benvonhandorf/nOPe-1/subassembly/encoder/prototype/TestFirmware/firmware/src/led_array/2023-01-15-16-36-17.png

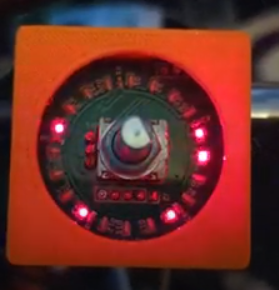
subassembly/encoder/prototype/TestFirmware/firmware/src/led_array/2023-01-15-16-36-17.png
