benvonhandorf/nOPe-1/subassembly/encoder/prototype/README.md

## Prototype Pinouts

- J1 - Communication header
  - 1 GND
  - 2 3.3V
  - 3 i2c SCL
  - 4 i2c SDA
  - 5 INT
- J2 - Programming Header
  - 1 GND
  - 2 3.3V
  - 3 ~RESET
  - 4 SWCLK
  - 5 SWDIO
