benvonhandorf/nOPe-1/subassembly/encoder/prototype/Rotary encoder board prototype schematic.pdf

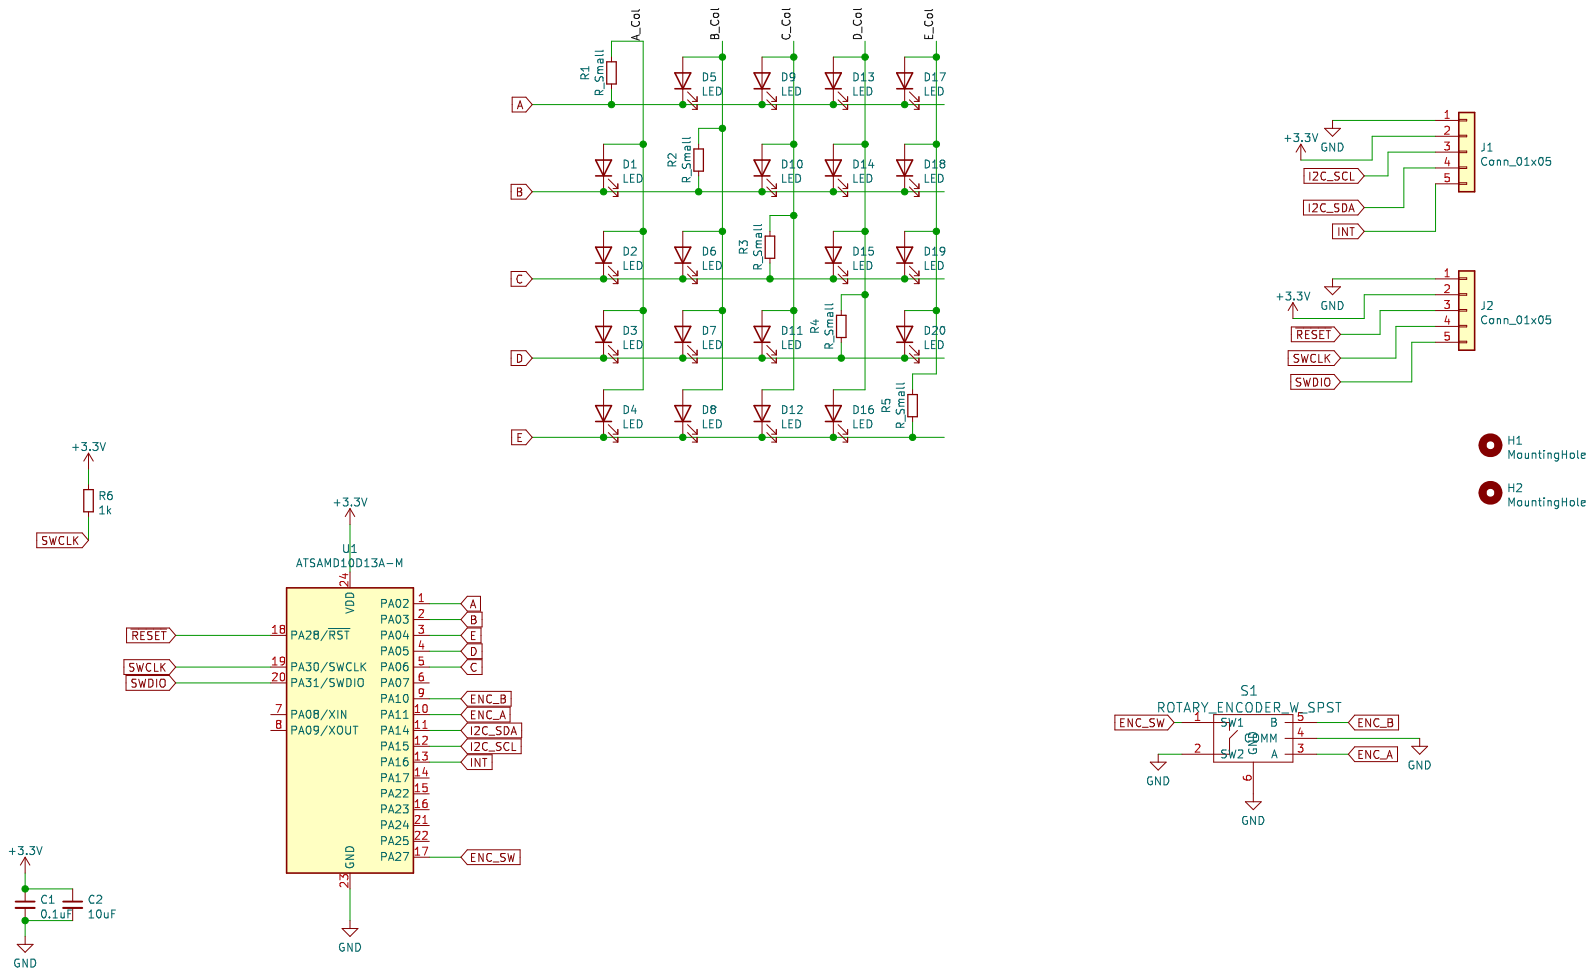
[picture p2: page 1]
