benvonhandorf/nOPe-1/subassembly/encoder/rotary_input_board/docs/schematic.pdf

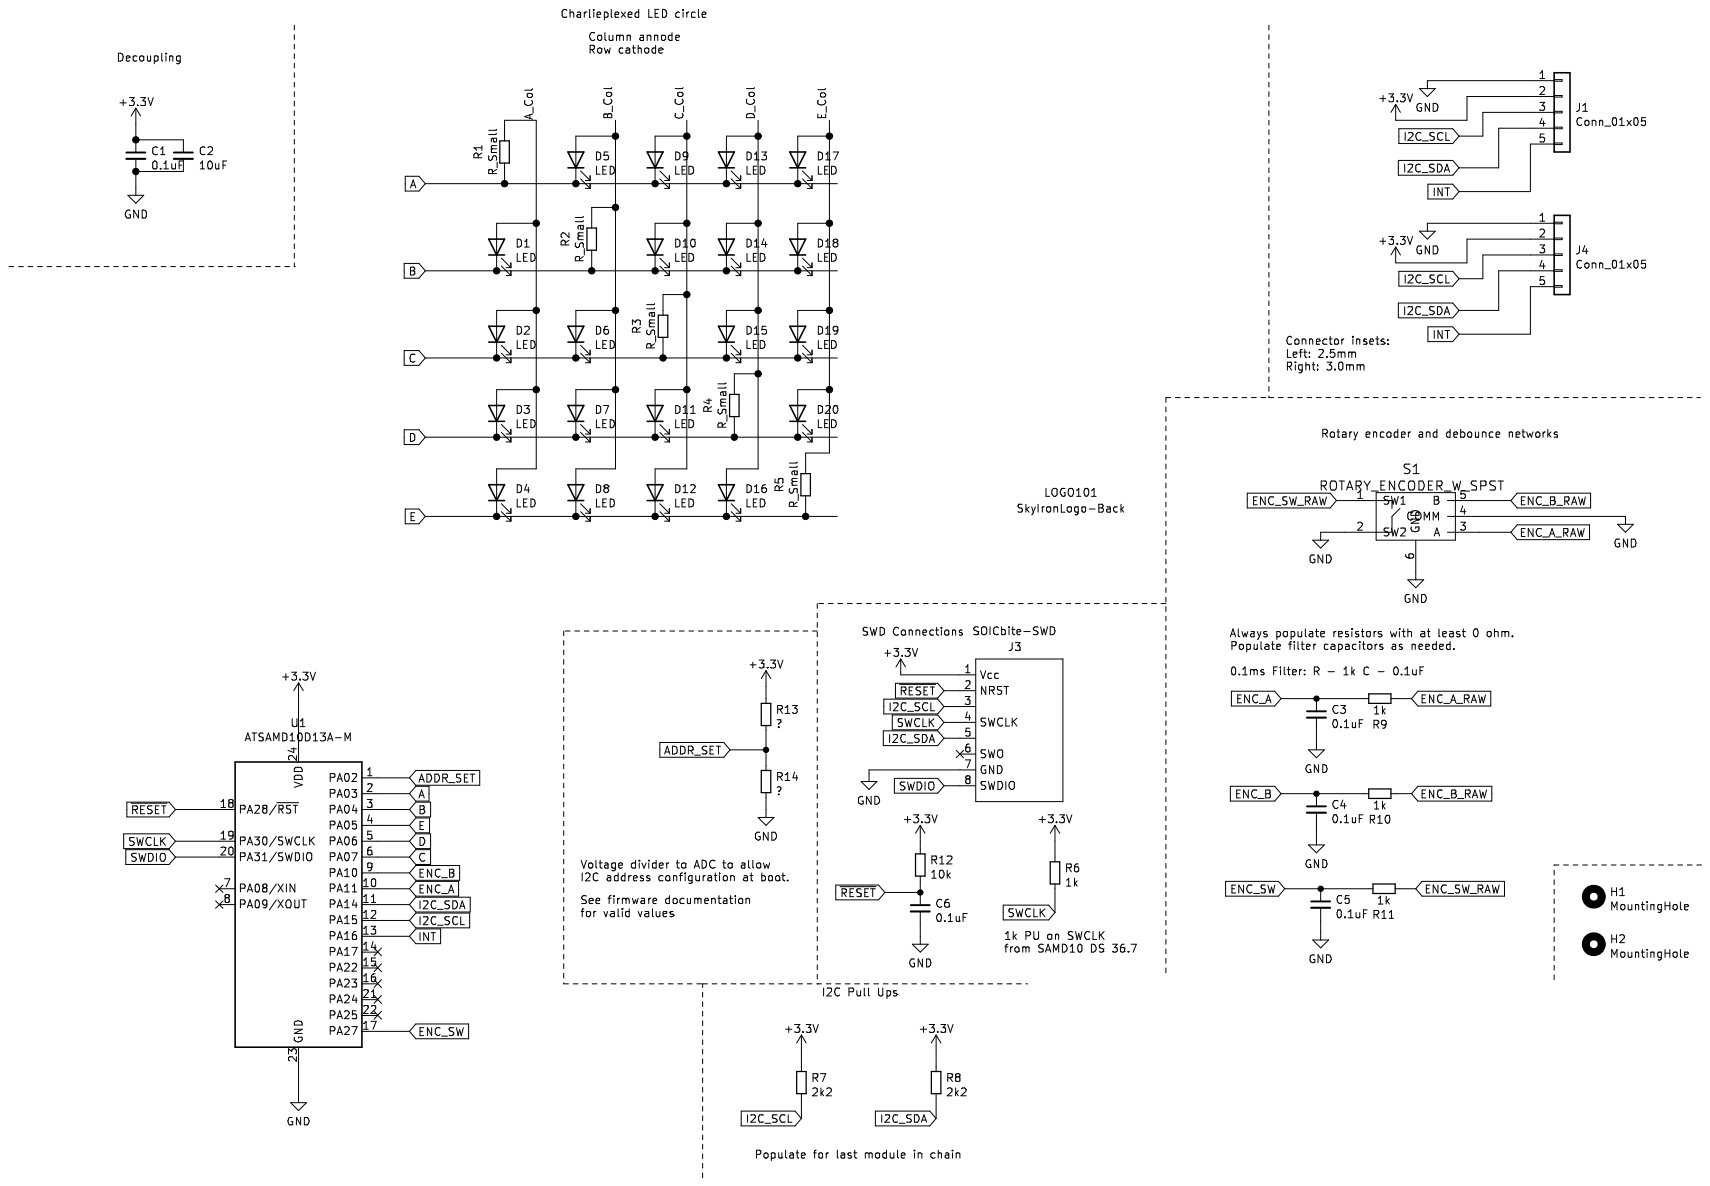
[picture p8: page 1]
