benvonhandorf/nOPe-1/subassembly/keyboard_matrix/keyboard_matrix/keyboard_matrix.kicad_pcb

## KiCad design subassembly/keyboard_matrix/keyboard_matrix/keyboard_matrix.kicad_pcb (2022-12-12)

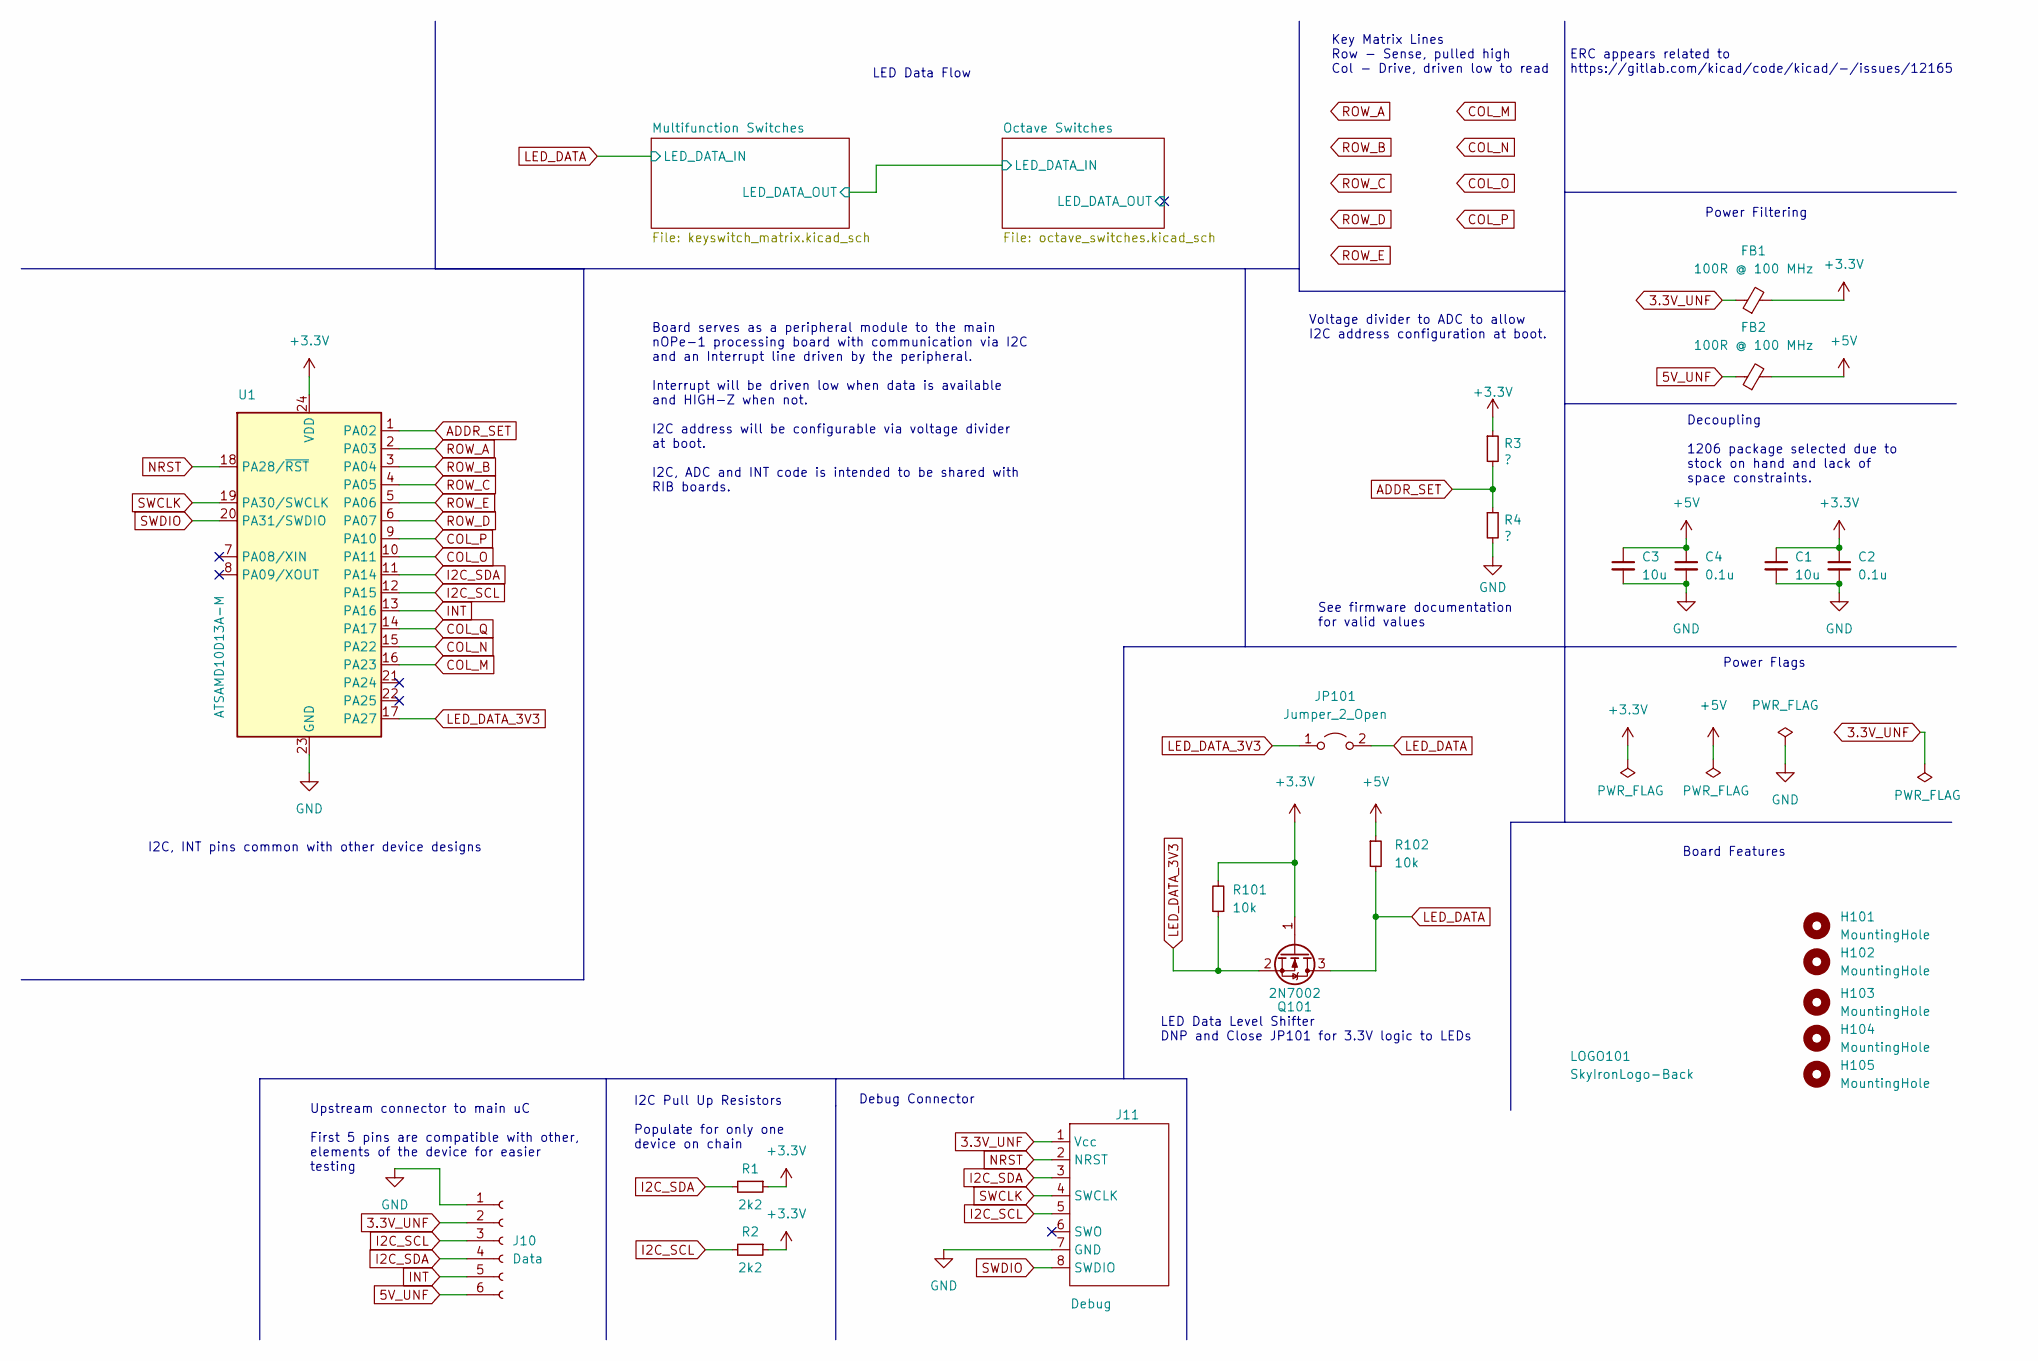
[picture p9: schematic keyboard_matrix.kicad_sch]

Parts:
C1, C3: 10u; C_1206_3216Metric_Pad1.33x1.80mm_HandSolder
C2, C4: 0.1u; C_1206_3216Metric_Pad1.33x1.80mm_HandSolder
FB1, FB2: 100R @ 100 MHz; R_0805_2012Metric_Pad1.20x1.40mm_HandSolder
H101, H102, H103, H104, H105: MountingHole; MountingHole_3.2mm_M3_DIN965
J10: Data; PinHeader_1x06_P2.54mm_Vertical
J11: Debug; SOICbite_renumbered
JP101: Jumper_2_Open; SolderJumper-2_P1.3mm_Open_Pad1.0x1.5mm
LOGO101: SkyIronLogo-Back; SkyIron_logo_Back
Q101: 2N7002; SOT-23
R1, R2: 2k2; R_0603_1608Metric
R3, R4: ?; R_0603_1608Metric
R101, R102: 10k; R_0805_2012Metric_Pad1.20x1.40mm_HandSolder
U1: ATSAMD10D13A-M; QFN-24-1EP_4x4mm_P0.5mm_EP2.6x2.6mm

Connections:
3.3V_UNF: FB1.1, J10.2, J11.1 (Vcc)
5V_UNF: FB2.1, J10.6
+3.3V: C1.1, C2.1, FB1.2, Q101.1 (G), R1.1, R2.1, R3.1, R101.2, U1.24 (VDD)
+5V: C3.1, C4.1, FB2.2, R102.1; also elsewhere on the board
ADDR_SET: R3.2, R4.1, U1.1 (PA02)
COL_M: U1.16 (PA23); also elsewhere on the board
COL_N: U1.15 (PA22); also elsewhere on the board
COL_O: U1.10 (PA11); also elsewhere on the board
COL_P: U1.9 (PA10); also elsewhere on the board
COL_Q: U1.14 (PA17); also elsewhere on the board
GND: C1.2, C2.2, C3.2, C4.2, J10.1, J11.7 (GND), R4.2, U1.23 (GND), U1.25 (GND); also elsewhere on the board
I2C_SCL: J10.3, J11.5, R2.2, U1.12 (PA15)
I2C_SDA: J10.4, J11.3, R1.2, U1.11 (PA14)
INT: J10.5, U1.13 (PA16)
LED_DATA: JP101.2 (B), Q101.3 (D), R102.2; also elsewhere on the board
LED_DATA_3V3: JP101.1 (A), Q101.2 (S), R101.1, U1.17 (PA27)
NRST: J11.2 (NRST), U1.18 (PA28/~RST)
ROW_A: U1.2 (PA03); also elsewhere on the board
ROW_B: U1.3 (PA04); also elsewhere on the board
ROW_C: U1.4 (PA05); also elsewhere on the board
ROW_D: U1.6 (PA07); also elsewhere on the board
ROW_E: U1.5 (PA06); also elsewhere on the board
SWCLK: J11.4 (SWCLK), U1.19 (PA30/SWCLK)
SWDIO: J11.8 (SWDIO), U1.20 (PA31/SWDIO)

Notes on the sheet:
I2C, INT pins common with other device designs
LED Data Flow
Upstream connector to main uC First 5 pins are compatible with other, elements of the device for easier testing
Power Flags
Voltage divider to ADC to allow I2C address configuration at boot.
LED Data Level Shifter DNP and Close JP101 for 3.3V logic to LEDs
I2C Pull Up Resistors Populate for only one device on chain
Board Features
Key Matrix Lines Row - Sense, pulled high Col - Drive, driven low to read
See firmware documentation for valid values
Debug Connector
Board serves as a peripheral module to the main nOPe-1 processing board with communication via I2C and an Interrupt line driven by the peripheral. Interrupt will be driven low when data is available and HIGH-Z when not. I2C address will be configurable via voltage divider at boot. I2C, ADC and INT 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
ERC appears related to https://gitlab.com/kicad/code/kicad/-/issues/12165
Decoupling 1206 package selected due to stock on hand and lack of space constraints.
Power Filtering

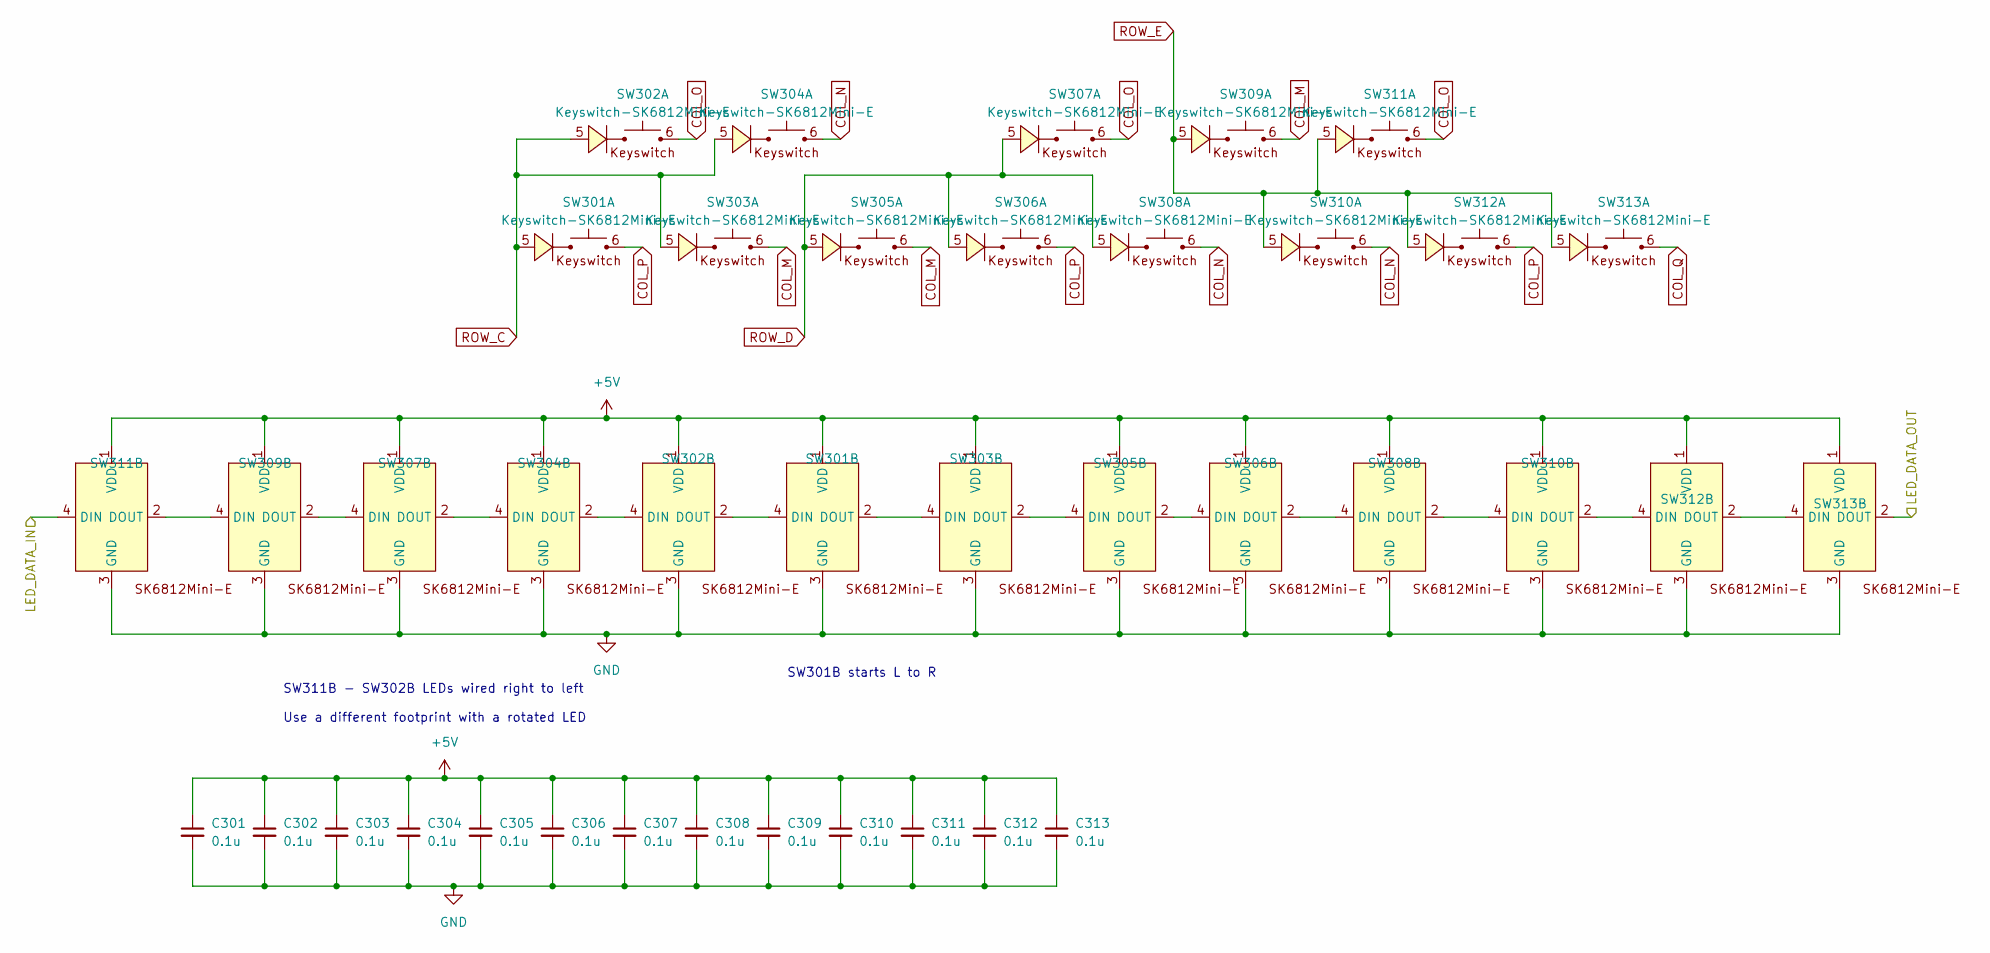
[picture p10: schematic octave_switches.kicad_sch]

Parts:
C301, C302, C303, C304, C305, C306, C307, C308, C309, C310, C311, C312, C313: 0.1u; C_1206_3216Metric_Pad1.33x1.80mm_HandSolder
SW301, SW303, SW305, SW306: Keyswitch-SK6812Mini-E; Keyswitch_Choc_SK6812_Diode_Vert_L
SW302, SW304, SW307, SW309, SW311: Keyswitch-SK6812Mini-E; Keyswitch_Choc_w_SK6812Mini-E_Back_SOD-103_Diode_RtoL
SW308, SW310, SW312, SW313: Keyswitch-SK6812Mini-E; Keyswitch_Choc_SK6812_Diode_Vert_R

Connections:
+5V: C301.1, C302.1, C303.1, C304.1, C305.1, C306.1, C307.1, C308.1, C309.1, C310.1, C311.1, C312.1, C313.1, SW301.1 (VDD), SW302.1 (VDD), SW303.1 (VDD), SW304.1 (VDD), SW305.1 (VDD), SW306.1 (VDD), SW307.1 (VDD), SW308.1 (VDD), SW309.1 (VDD), SW310.1 (VDD), SW311.1 (VDD), SW312.1 (VDD), SW313.1 (VDD); also elsewhere on the board
/Multifunction Switches/LED_DATA_OUT: SW311.4 (DIN); also elsewhere on the board
/Octave Switches/LED_DATA_OUT: SW313.2 (DOUT)
COL_M: SW303.6, SW305.6, SW309.6; also elsewhere on the board
COL_N: SW304.6, SW308.6, SW310.6; also elsewhere on the board
COL_O: SW302.6, SW307.6, SW311.6; also elsewhere on the board
COL_P: SW301.6, SW306.6, SW312.6; also elsewhere on the board
COL_Q: SW313.6; also elsewhere on the board
GND: C301.2, C302.2, C303.2, C304.2, C305.2, C306.2, C307.2, C308.2, C309.2, C310.2, C311.2, C312.2, C313.2, SW301.3 (GND), SW302.3 (GND), SW303.3 (GND), SW304.3 (GND), SW305.3 (GND), SW306.3 (GND), SW307.3 (GND), SW308.3 (GND), SW309.3 (GND), SW310.3 (GND), SW311.3 (GND), SW312.3 (GND), SW313.3 (GND); also elsewhere on the board
unnamed: SW301.2 (DOUT), SW303.4 (DIN)
unnamed: SW301.4 (DIN), SW302.2 (DOUT)
unnamed: SW302.4 (DIN), SW304.2 (DOUT)
unnamed: SW303.2 (DOUT), SW305.4 (DIN)
unnamed: SW304.4 (DIN), SW307.2 (DOUT)
unnamed: SW305.2 (DOUT), SW306.4 (DIN)
unnamed: SW306.2 (DOUT), SW308.4 (DIN)
unnamed: SW307.4 (DIN), SW309.2 (DOUT)
unnamed: SW308.2 (DOUT), SW310.4 (DIN)
unnamed: SW309.4 (DIN), SW311.2 (DOUT)
unnamed: SW310.2 (DOUT), SW312.4 (DIN)
unnamed: SW312.2 (DOUT), SW313.4 (DIN)
ROW_C: SW301.5, SW302.5, SW303.5, SW304.5; also elsewhere on the board
ROW_D: SW305.5, SW306.5, SW307.5, SW308.5; also elsewhere on the board
ROW_E: SW309.5, SW310.5, SW311.5, SW312.5, SW313.5; also elsewhere on the board

Notes on the sheet:
SW301B starts L to R
SW311B - SW302B LEDs wired right to left Use a different footprint with a rotated LED

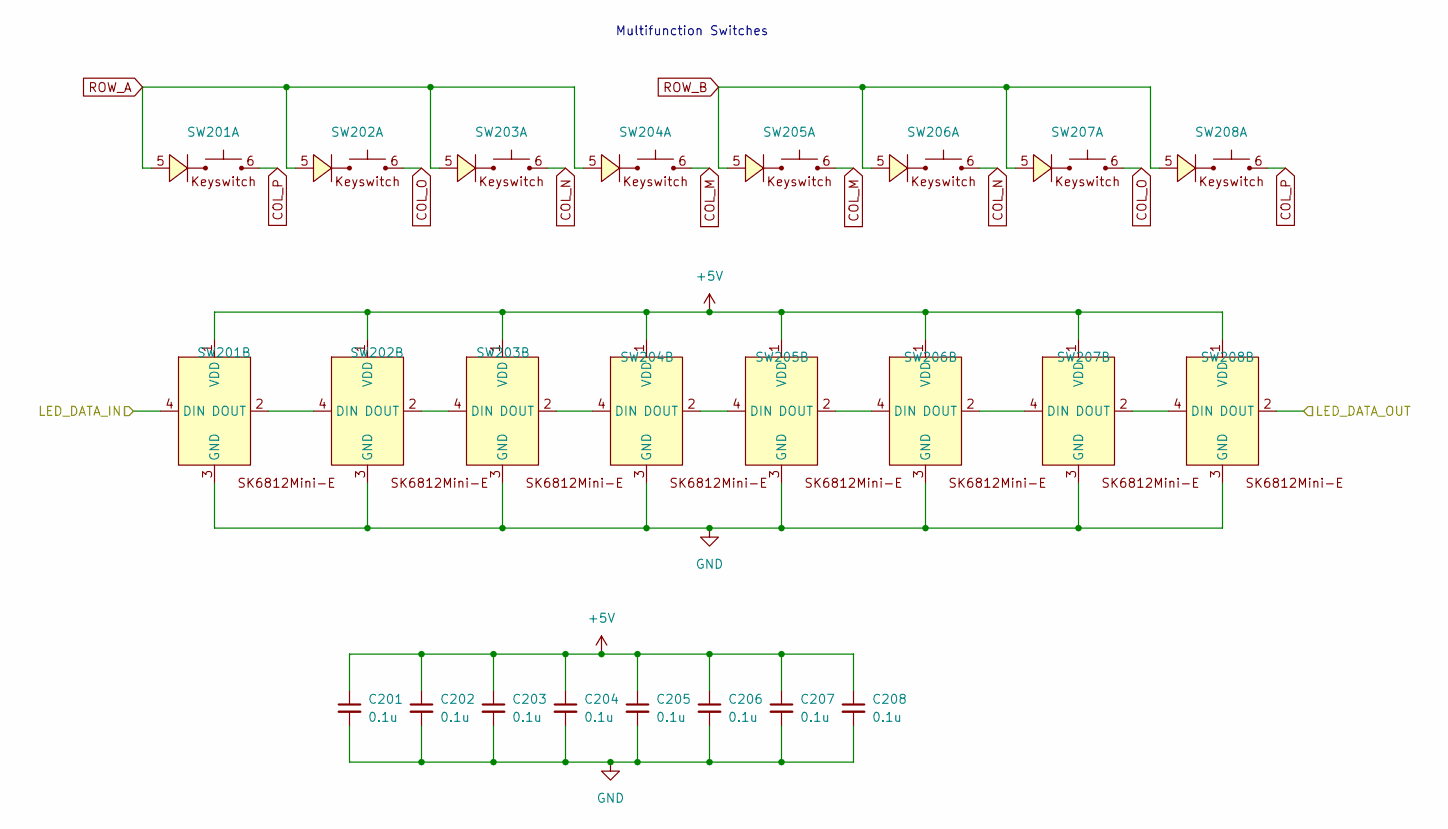
[picture p11: schematic keyswitch_matrix.kicad_sch]

Parts:
C201, C202, C203, C204, C205, C206, C207, C208: 0.1u; C_1206_3216Metric_Pad1.33x1.80mm_HandSolder
SW201, SW202, SW203, SW204, SW205, SW206, SW207, SW208: Keyswitch-SK6812Mini-E; Keyswitch_Choc_w_SK6812Mini-E_Back_SOD-103_Diode_LtoR

Connections:
+5V: C201.1, C202.1, C203.1, C204.1, C205.1, C206.1, C207.1, C208.1, SW201.1 (VDD), SW202.1 (VDD), SW203.1 (VDD), SW204.1 (VDD), SW205.1 (VDD), SW206.1 (VDD), SW207.1 (VDD), SW208.1 (VDD); also elsewhere on the board
/Multifunction Switches/LED_DATA_OUT: SW208.2 (DOUT); also elsewhere on the board
COL_M: SW204.6, SW205.6; also elsewhere on the board
COL_N: SW203.6, SW206.6; also elsewhere on the board
COL_O: SW202.6, SW207.6; also elsewhere on the board
COL_P: SW201.6, SW208.6; also elsewhere on the board
GND: C201.2, C202.2, C203.2, C204.2, C205.2, C206.2, C207.2, C208.2, SW201.3 (GND), SW202.3 (GND), SW203.3 (GND), SW204.3 (GND), SW205.3 (GND), SW206.3 (GND), SW207.3 (GND), SW208.3 (GND); also elsewhere on the board
LED_DATA: SW201.4 (DIN); also elsewhere on the board
unnamed: SW201.2 (DOUT), SW202.4 (DIN)
unnamed: SW202.2 (DOUT), SW203.4 (DIN)
unnamed: SW203.2 (DOUT), SW204.4 (DIN)
unnamed: SW204.2 (DOUT), SW205.4 (DIN)
unnamed: SW205.2 (DOUT), SW206.4 (DIN)
unnamed: SW206.2 (DOUT), SW207.4 (DIN)
unnamed: SW207.2 (DOUT), SW208.4 (DIN)
ROW_A: SW201.5, SW202.5, SW203.5, SW204.5; also elsewhere on the board
ROW_B: SW205.5, SW206.5, SW207.5, SW208.5; also elsewhere on the board

Notes on the sheet:
Multifunction Switches

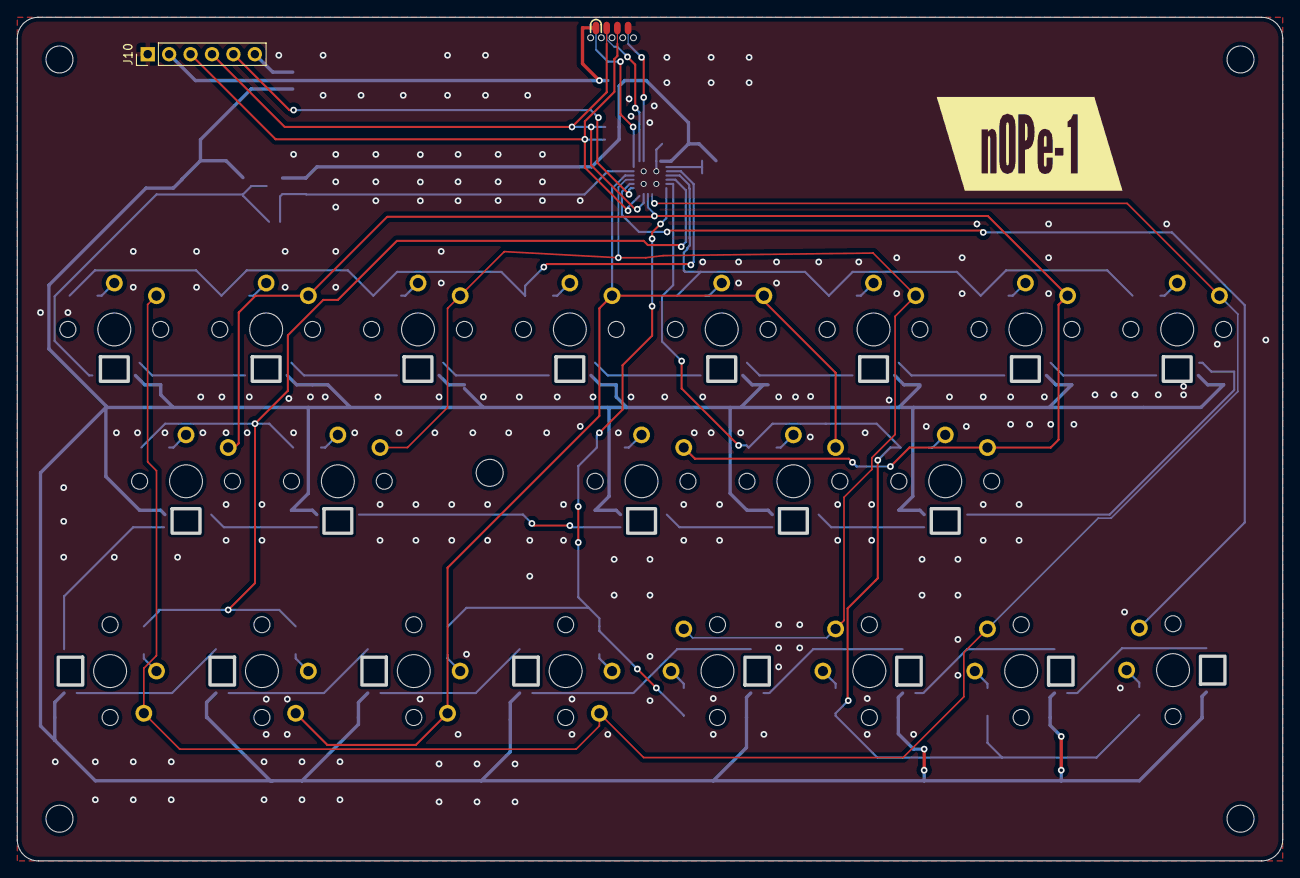
[picture p12: board keyboard_matrix.kicad_pcb from above]

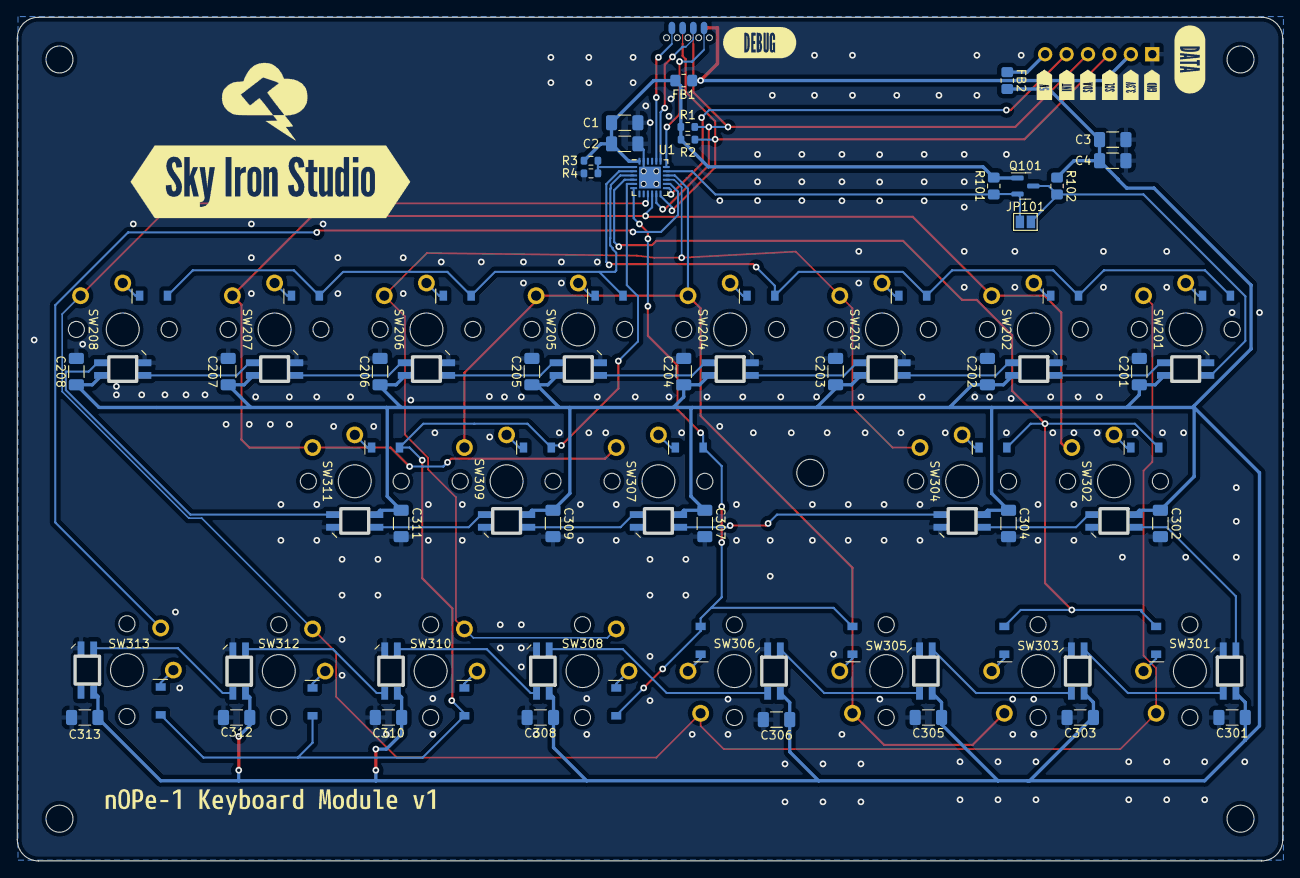
[picture p13: board keyboard_matrix.kicad_pcb from below]

Board: 2 copper layers, 150.0 x 100.0 mm, 76 parts (46 on the bottom side), 44 nets.

Other parts of the board:
kibuzzard-6388C4FD: G***; kibuzzard-6388C4FD
kibuzzard-6388C06F: G***; kibuzzard-6388C06F
kibuzzard-6388C51A: G***; kibuzzard-6388C51A
kibuzzard-6388C61B: G***; kibuzzard-6388C61B
kibuzzard-6388C408: G***; kibuzzard-6388C408
kibuzzard-6388C475: G***; kibuzzard-6388C475
kibuzzard-6388C535: G***; kibuzzard-6388C535
kibuzzard-6388C552: G***; kibuzzard-6388C552
kibuzzard-6388C567: G***; kibuzzard-6388C567
kibuzzard-6388C579: G***; kibuzzard-6388C579
kibuzzard-6388D403: G***; kibuzzard-6388D403
