benvonhandorf/nOPe-1/subassembly/encoder/rotary_input_board/rotary_input_board.kicad_pcb

## KiCad design subassembly/encoder/rotary_input_board/rotary_input_board.kicad_pcb (2022-12-12)

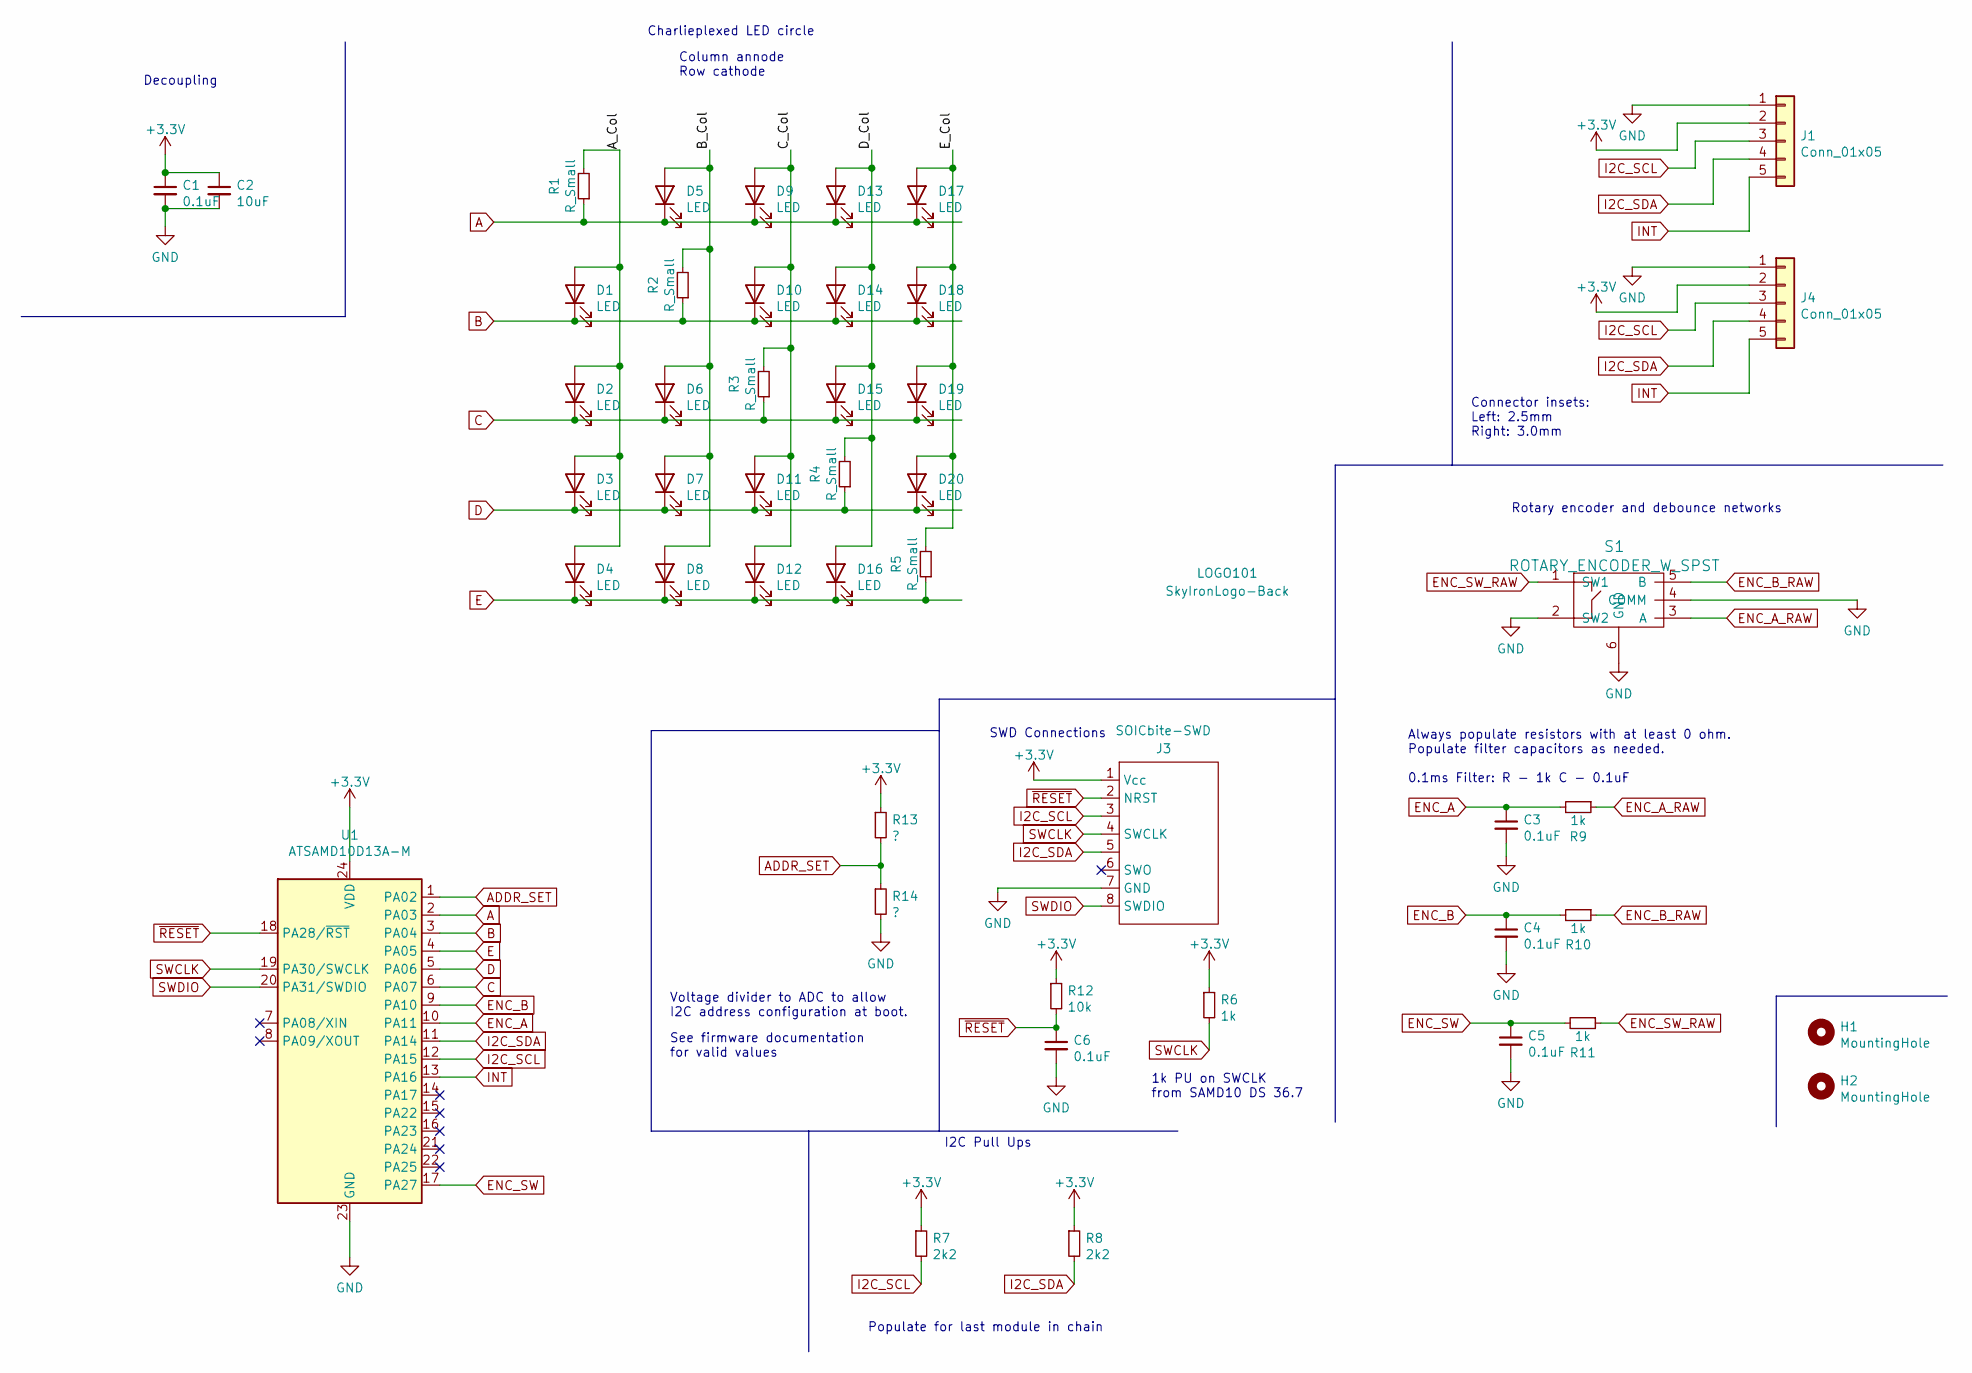
[picture p14: schematic rotary_input_board.kicad_sch]

Parts:
C1, C3, C4, C5, C6: 0.1uF; C_0603_1608Metric
C2: 10uF; C_0805_2012Metric
D1, D2, D3, D4, D5, D6, D7, D8, D9, D10, D11, D12, D13, D14, D15, D16, D17, D18, D19, D20: LED; LED_0603_1608Metric
H1, H2: MountingHole; MountingHole_2.5mm
J1, J4: Conn_01x05; PinSocket_1x05_P1.27mm_Vertical
J3: SOICbite-SWD; SOICbite_renumbered
LOGO101: SkyIronLogo-Back; SkyIron_logo_Back
R1, R2, R3, R4, R5: R_Small; R_0603_1608Metric
R6, R9, R10, R11: 1k; R_0603_1608Metric
R7, R8: 2k2; R_0603_1608Metric
R12: 10k; R_0603_1608Metric
R13, R14: ?; R_0603_1608Metric
S1: ROTARY_ENCODER_W_SPST; Rotary_Encoder_W_Switch
U1: ATSAMD10D13A-M; QFN-24-1EP_4x4mm_P0.5mm_EP2.6x2.6mm

Connections:
+3.3V: C1.1, C2.1, J1.2, J3.1 (Vcc), J4.2, R6.1, R7.1, R8.1, R12.1, R13.1, U1.24 (VDD)
/A_Col: D1.2 (A), D2.2 (A), D3.2 (A), D4.2 (A), R1.2
/B_Col: D5.2 (A), D6.2 (A), D7.2 (A), D8.2 (A), R2.2
/C_Col: D9.2 (A), D10.2 (A), D11.2 (A), D12.2 (A), R3.2
/D_Col: D13.2 (A), D14.2 (A), D15.2 (A), D16.2 (A), R4.2
/E_Col: D17.2 (A), D18.2 (A), D19.2 (A), D20.2 (A), R5.2
A: D5.1 (K), D9.1 (K), D13.1 (K), D17.1 (K), R1.1, U1.2 (PA03)
ADDR_SET: R13.2, R14.1, U1.1 (PA02)
B: D1.1 (K), D10.1 (K), D14.1 (K), D18.1 (K), R2.1, U1.3 (PA04)
C: D2.1 (K), D6.1 (K), D15.1 (K), D19.1 (K), R3.1, U1.6 (PA07)
D: D3.1 (K), D7.1 (K), D11.1 (K), D20.1 (K), R4.1, U1.5 (PA06)
E: D4.1 (K), D8.1 (K), D12.1 (K), D16.1 (K), R5.1, U1.4 (PA05)
ENC_A: C3.1, R9.2, U1.10 (PA11)
ENC_A_RAW: R9.1, S1.3 (A)
ENC_B: C4.1, R10.2, U1.9 (PA10)
ENC_B_RAW: R10.1, S1.5 (B)
ENC_SW: C5.1, R11.2, U1.17 (PA27)
ENC_SW_RAW: R11.1, S1.1 (SW1)
GND: C1.2, C2.2, C3.2, C4.2, C5.2, C6.2, J1.1, J3.7 (GND), J4.1, R14.2, S1.2 (SW2), S1.4 (COMM), S1.6 (GND), U1.23 (GND), U1.25 (GND)
I2C_SCL: J1.3, J3.3, J4.3, R7.2, U1.12 (PA15)
I2C_SDA: J1.4, J3.5, J4.4, R8.2, U1.11 (PA14)
INT: J1.5, J4.5, U1.13 (PA16)
SWCLK: J3.4 (SWCLK), R6.2, U1.19 (PA30/SWCLK)
SWDIO: J3.8 (SWDIO), U1.20 (PA31/SWDIO)
~RESET: C6.1, J3.2 (NRST), R12.2, U1.18 (PA28/~RST)

Notes on the sheet:
1k PU on SWCLK from SAMD10 DS 36.7
Populate for last module in chain
Rotary encoder and debounce networks
I2C Pull Ups
See firmware documentation for valid values
Column annode Row cathode
Voltage divider to ADC to allow I2C address configuration at boot.
SWD Connections
Decoupling
Charlieplexed LED circle
Connector insets: Left: 2.5mm Right: 3.0mm
Always populate resistors with at least 0 ohm. Populate filter capacitors as needed. 0.1ms Filter: R - 1k C - 0.1uF

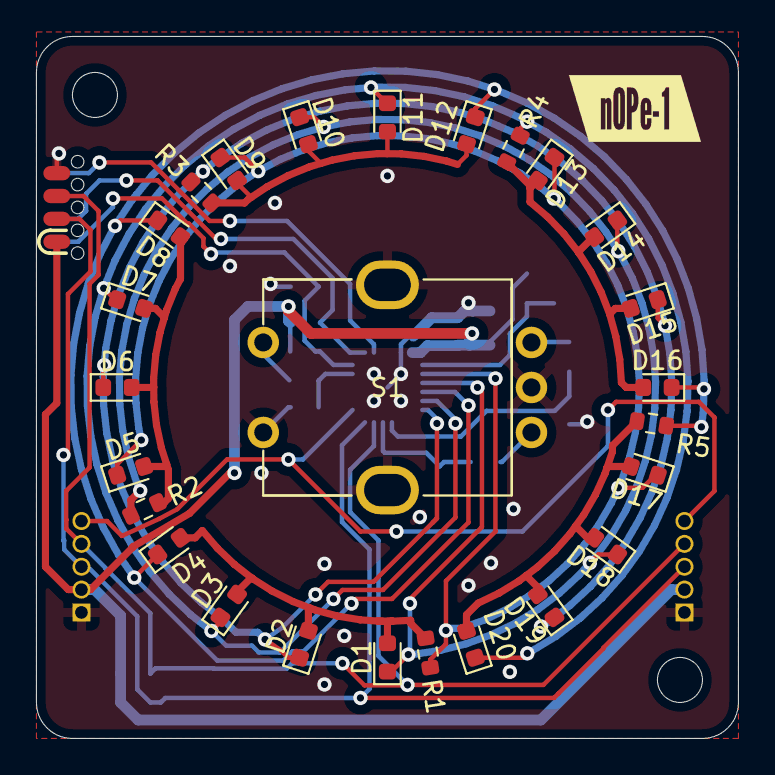
[picture p15: board rotary_input_board.kicad_pcb from above]

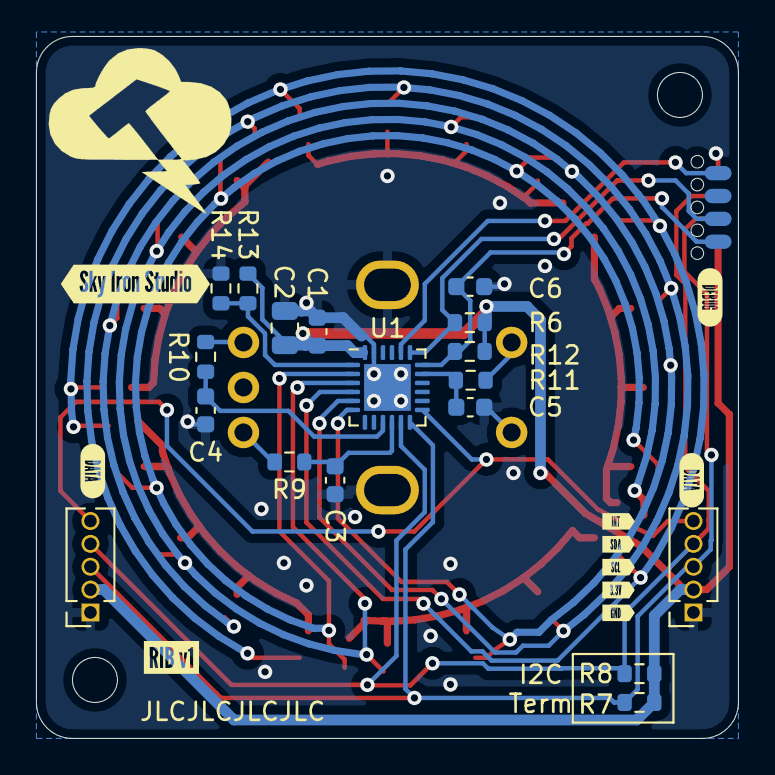
[picture p16: board rotary_input_board.kicad_pcb from below]

Board: 4 copper layers, 39.0 x 39.0 mm, 59 parts (28 on the bottom side), 25 nets.

Other parts of the board:
kibuzzard-63921B01: G***; kibuzzard-63921B01
kibuzzard-63921BF7: G***; kibuzzard-63921BF7
kibuzzard-63921CC8: G***; kibuzzard-63921CC8
kibuzzard-63921CE0: G***; kibuzzard-63921CE0
kibuzzard-63921CF0: G***; kibuzzard-63921CF0
kibuzzard-63921CFB: G***; kibuzzard-63921CFB
kibuzzard-63921D08: G***; kibuzzard-63921D08
kibuzzard-63921DF1, kibuzzard-63921DF1#2: G***; kibuzzard-63921DF1
kibuzzard-63921E31: G***; kibuzzard-63921E31
kibuzzard-639219D7: G***; kibuzzard-639219D7
