benvonhandorf/nOPe-1/subassembly/encoder/prototype/TestFirmware/firmware-mplabx/src/controller.h

/* 
 * File:   controller.h
 * Author: benvh
 *
 * Created on May 29, 2021, 3:44 PM
 */

#ifndef CONTROLLER_H
#define	CONTROLLER_H

#ifdef	__cplusplus
extern "C" {
#endif

void controller_init();

void controller_tick();


#ifdef	__cplusplus
}
#endif

#endif	/* CONTROLLER_H */
