benvonhandorf/nOPe-1/subassembly/encoder/prototype/TestFirmware/firmware/src/config/default/peripheral/sercom/i2c_slave/plib_sercom0_i2c_slave.c

/*******************************************************************************
  Serial Communication Interface Inter-Integrated Circuit (SERCOM I2C) Library
  Source File

  Company:
    Microchip Technology Inc.

  File Name:
    plib_sercom0_i2c_slave.c

  Summary:
    SERCOM I2C PLIB Slave Implementation file

  Description:
    This file defines the interface to the SERCOM I2C Slave peripheral library.
    This library provides access to and control of the associated peripheral
    instance.

*******************************************************************************/
// DOM-IGNORE-BEGIN
/*******************************************************************************
* Copyright (C) 2018 Microchip Technology Inc. and its subsidiaries.
*
* Subject to your compliance with these terms, you may use Microchip software
* and any derivatives exclusively with Microchip products. It is your
* responsibility to comply with third party license terms applicable to your
* use of third party software (including open source software) that may
* accompany Microchip software.
*
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
* IN NO EVENT WILL MICROCHIP BE LIABLE FOR ANY INDIRECT, SPECIAL, PUNITIVE,
* INCIDENTAL OR CONSEQUENTIAL LOSS, DAMAGE, COST OR EXPENSE OF ANY KIND
* WHATSOEVER RELATED TO THE SOFTWARE, HOWEVER CAUSED, EVEN IF MICROCHIP HAS
* BEEN ADVISED OF THE POSSIBILITY OR THE DAMAGES ARE FORESEEABLE. TO THE
* FULLEST EXTENT ALLOWED BY LAW, MICROCHIP'S TOTAL LIABILITY ON ALL CLAIMS IN
* ANY WAY RELATED TO THIS SOFTWARE WILL NOT EXCEED THE AMOUNT OF FEES, IF ANY,
* THAT YOU HAVE PAID DIRECTLY TO MICROCHIP FOR THIS SOFTWARE.
*******************************************************************************/
// DOM-IGNORE-END


// *****************************************************************************
// *****************************************************************************
// Section: Included Files
// *****************************************************************************
// *****************************************************************************

#include "plib_sercom0_i2c_slave.h"

// *****************************************************************************
// *****************************************************************************
// Section: Global Data
// *****************************************************************************
// *****************************************************************************
static SERCOM_I2C_SLAVE_OBJ sercom0I2CSObj;
// *****************************************************************************
// *****************************************************************************
// Section: SERCOM0 I2C Implementation
// *****************************************************************************
// *****************************************************************************
// *****************************************************************************

// *****************************************************************************
/* Function:
    void SERCOM0_I2C_Initialize(void)

  Summary:
    Initializes the instance of the SERCOM peripheral operating in I2C mode.

  Description:
    This function initializes the given instance of the SERCOM I2C peripheral as
    configured by the user from the MHC.

  Remarks:
    Refer plib_SERCOM0_i2c.h for more information.
*/

void SERCOM0_I2C_Initialize(void)
{
    /* Reset the module */
    SERCOM0_REGS->I2CS.SERCOM_CTRLA = SERCOM_I2CS_CTRLA_SWRST_Msk ;

    /* Wait for synchronization */
    while((SERCOM0_REGS->I2CS.SERCOM_SYNCBUSY) != 0U)
    {
        /* Do nothing */
    }
     /* Set Operation Mode to I2C Slave */
    SERCOM0_REGS->I2CS.SERCOM_CTRLA = SERCOM_I2CS_CTRLA_MODE_I2C_SLAVE | SERCOM_I2CS_CTRLA_SDAHOLD_75NS | SERCOM_I2CS_CTRLA_SCLSM(0UL) | SERCOM_I2CS_CTRLA_SPEED_STANDARD_AND_FAST_MODE ;
    /* Wait for synchronization */
    while((SERCOM0_REGS->I2CS.SERCOM_SYNCBUSY) != 0U)
    {
        /* Do nothing */
    }


    /* Set the slave address */
    SERCOM0_REGS->I2CS.SERCOM_ADDR = SERCOM_I2CS_ADDR_ADDR(0x54UL) ;


    /* Enable all I2C slave Interrupts */
    SERCOM0_REGS->I2CS.SERCOM_INTENSET = (uint8_t)SERCOM_I2CS_INTENSET_Msk;

    /* Enable peripheral */
    SERCOM0_REGS->I2CS.SERCOM_CTRLA |= SERCOM_I2CS_CTRLA_ENABLE_Msk ;

    /* Wait for synchronization */
    while((SERCOM0_REGS->I2CS.SERCOM_SYNCBUSY) != 0U)
    {
        /* Do nothing */
    }
}

void SERCOM0_I2C_CallbackRegister(SERCOM_I2C_SLAVE_CALLBACK callback, uintptr_t contextHandle)
{
    sercom0I2CSObj.callback = callback;

    sercom0I2CSObj.context  = contextHandle;
}

bool SERCOM0_I2C_IsBusy(void)
{
    return sercom0I2CSObj.isBusy;
}


uint8_t SERCOM0_I2C_ReadByte(void)
{
    /* Wait for synchronization */
    while((SERCOM0_REGS->I2CS.SERCOM_SYNCBUSY) != 0U)
    {
        /* Do nothing */
    }

    return SERCOM0_REGS->I2CS.SERCOM_DATA;
}

void SERCOM0_I2C_WriteByte(uint8_t wrByte)
{
    SERCOM0_REGS->I2CS.SERCOM_DATA = wrByte;

    /* Wait for synchronization */
    while((SERCOM0_REGS->I2CS.SERCOM_SYNCBUSY) != 0U)
    {
        /* Do nothing */
    }
}

SERCOM_I2C_SLAVE_ERROR SERCOM0_I2C_ErrorGet(void)
{
    SERCOM_I2C_SLAVE_ERROR error;
    error = (SERCOM0_REGS->I2CS.SERCOM_STATUS & SERCOM_I2C_SLAVE_ERROR_ALL);

    /* Clear all error bits */
    SERCOM0_REGS->I2CS.SERCOM_STATUS = (uint16_t)SERCOM_I2C_SLAVE_ERROR_ALL;

    return error;
}

SERCOM_I2C_SLAVE_TRANSFER_DIR SERCOM0_I2C_TransferDirGet(void)
{
    return ((SERCOM0_REGS->I2CS.SERCOM_STATUS & SERCOM_I2CS_STATUS_DIR_Msk) != 0U) ? SERCOM_I2C_SLAVE_TRANSFER_DIR_READ: SERCOM_I2C_SLAVE_TRANSFER_DIR_WRITE;
}

SERCOM_I2C_SLAVE_ACK_STATUS SERCOM0_I2C_LastByteAckStatusGet(void)
{
    return ((SERCOM0_REGS->I2CS.SERCOM_STATUS & SERCOM_I2CS_STATUS_RXNACK_Msk) != 0U) ? SERCOM_I2C_SLAVE_ACK_STATUS_RECEIVED_NAK : SERCOM_I2C_SLAVE_ACK_STATUS_RECEIVED_ACK;
}

void SERCOM0_I2C_CommandSet(SERCOM_I2C_SLAVE_COMMAND command)
{
    if (command == SERCOM_I2C_SLAVE_COMMAND_SEND_ACK)
    {
        SERCOM0_REGS->I2CS.SERCOM_CTRLB = (SERCOM0_REGS->I2CS.SERCOM_CTRLB | SERCOM_I2CS_CTRLB_CMD(0x03UL)) & (~SERCOM_I2CS_CTRLB_ACKACT_Msk);
    }
    else if (command == SERCOM_I2C_SLAVE_COMMAND_SEND_NAK)
    {
        SERCOM0_REGS->I2CS.SERCOM_CTRLB |= (SERCOM_I2CS_CTRLB_CMD(0x03UL) | (SERCOM_I2CS_CTRLB_ACKACT_Msk));
    }
    else if (command == SERCOM_I2C_SLAVE_COMMAND_RECEIVE_ACK_NAK)
    {
        SERCOM0_REGS->I2CS.SERCOM_CTRLB = (SERCOM0_REGS->I2CS.SERCOM_CTRLB | SERCOM_I2CS_CTRLB_CMD(0x03UL));
    }
    else if (command == SERCOM_I2C_SLAVE_COMMAND_WAIT_FOR_START)
    {
        SERCOM0_REGS->I2CS.SERCOM_CTRLB = (SERCOM0_REGS->I2CS.SERCOM_CTRLB & ~SERCOM_I2CS_CTRLB_CMD_Msk) | SERCOM_I2CS_CTRLB_CMD(0x02UL);
    }
    else
    {
        /* Do nothing, return */
    }
}

void SERCOM0_I2C_InterruptHandler(void)
{
    uint32_t intFlags = SERCOM0_REGS->I2CS.SERCOM_INTFLAG;

    if((intFlags & SERCOM0_REGS->I2CS.SERCOM_INTENSET) != 0U)
    {
        if ((intFlags & SERCOM_I2CS_INTFLAG_AMATCH_Msk) != 0U)
        {
            sercom0I2CSObj.isBusy = true;

            sercom0I2CSObj.isFirstRxAfterAddressPending = true;

            sercom0I2CSObj.isRepeatedStart = ((SERCOM0_REGS->I2CS.SERCOM_STATUS & SERCOM_I2CS_STATUS_SR_Msk) != 0U) ? true : false;

            if (sercom0I2CSObj.callback != NULL)
            {
                if (sercom0I2CSObj.callback(SERCOM_I2C_SLAVE_TRANSFER_EVENT_ADDR_MATCH, sercom0I2CSObj.context) == true)
                {
                    SERCOM0_I2C_CommandSet(SERCOM_I2C_SLAVE_COMMAND_SEND_ACK);
                }
                else
                {
                    SERCOM0_I2C_CommandSet(SERCOM_I2C_SLAVE_COMMAND_SEND_NAK);
                }
            }
        }
        if ((intFlags & SERCOM_I2CS_INTFLAG_DRDY_Msk) != 0U)
        {
            if (sercom0I2CSObj.callback != NULL)
            {
                if (SERCOM0_I2C_TransferDirGet() == SERCOM_I2C_SLAVE_TRANSFER_DIR_WRITE)
                {
                    if (sercom0I2CSObj.callback(SERCOM_I2C_SLAVE_TRANSFER_EVENT_RX_READY, sercom0I2CSObj.context) == true)
                    {
                        SERCOM0_I2C_CommandSet(SERCOM_I2C_SLAVE_COMMAND_SEND_ACK);
                    }
                    else
                    {
                        SERCOM0_I2C_CommandSet(SERCOM_I2C_SLAVE_COMMAND_SEND_NAK);
                    }
                }
                else
                {
                    if ((SERCOM0_I2C_LastByteAckStatusGet() == SERCOM_I2C_SLAVE_ACK_STATUS_RECEIVED_ACK) || (sercom0I2CSObj.isFirstRxAfterAddressPending == true))
                    {
                        bool status = sercom0I2CSObj.callback(SERCOM_I2C_SLAVE_TRANSFER_EVENT_TX_READY, sercom0I2CSObj.context);
                        (void)status;
                        sercom0I2CSObj.isFirstRxAfterAddressPending = false;
                        SERCOM0_I2C_CommandSet(SERCOM_I2C_SLAVE_COMMAND_RECEIVE_ACK_NAK);
                    }
                    else
                    {
                        SERCOM0_I2C_CommandSet(SERCOM_I2C_SLAVE_COMMAND_WAIT_FOR_START);
                    }
                }
            }
        }
        if ((intFlags & SERCOM_I2CS_INTFLAG_PREC_Msk) != 0U)
        {
            sercom0I2CSObj.isBusy = false;

            if (sercom0I2CSObj.callback != NULL)
            {
                bool status = sercom0I2CSObj.callback(SERCOM_I2C_SLAVE_TRANSFER_EVENT_STOP_BIT_RECEIVED, sercom0I2CSObj.context);
                (void)status;
            }

            SERCOM0_REGS->I2CS.SERCOM_INTFLAG = (uint8_t)SERCOM_I2CS_INTFLAG_PREC_Msk;
        }
        if ((intFlags & SERCOM_I2CS_INTFLAG_ERROR_Msk) != 0U)
        {
            if (sercom0I2CSObj.callback != NULL)
            {
                bool status = sercom0I2CSObj.callback(SERCOM_I2C_SLAVE_TRANSFER_EVENT_ERROR, sercom0I2CSObj.context);
                (void)status;
            }

            SERCOM0_REGS->I2CS.SERCOM_INTFLAG = (uint8_t)SERCOM_I2CS_INTFLAG_ERROR_Msk;
        }
    }
}
