benvonhandorf/nOPe-1/(commit log)

2021-04-08 First commit - KiCad and MPLABX migration
    [kicad_circular_tracks_test.kicad_pcb, kicad_circular_tracks_test.kicad_sch]
2021-04-09 WIP Encoder support
2021-04-10 Encoder WIP
2021-04-28 Fix for encoder
    [kicad_circular_tracks_test.kicad_pcb]
2021-04-28 Add keyboard module
    [encoder_keyboard_module.kicad_pcb, encoder_keyboard_module.kicad_sch]
2021-05-29 WIP Basic I2C working, controller refactor in process
2022-11-06 SOICbite connector, RC filters for inputs
    [kicad_circular_tracks_test.kicad_pcb, kicad_circular_tracks_test.kicad_sch]
2022-12-07 Keyboard matrix prototype + encoder update
    [keyboard_matrix-B_Cu.gbr, keyboard_matrix-B_Mask.gbr, keyboard_matrix-B_Paste.gbr, keyboard_matrix-B_Silkscreen.gbr, keyboard_matrix-Edge_Cuts.gbr, keyboard_matrix-F_Cu.gbr, keyboard_matrix-F_Mask.gbr, keyboard_matrix-F_Paste.gbr]
2022-12-12 First run of keyboard board and move prototype board to rotary_encoder_board
    [encoder_keyboard_module.kicad_pcb, encoder_keyboard_module.kicad_sch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]
2022-12-21 WIP and organization
    [keyboard_matrix-B_Cu.gbr, keyboard_matrix-B_Mask.gbr, keyboard_matrix-B_Paste.gbr, keyboard_matrix-B_Silkscreen.gbr, keyboard_matrix-Edge_Cuts.gbr, keyboard_matrix-F_Cu.gbr, keyboard_matrix-F_Mask.gbr, keyboard_matrix-F_Paste.gbr]
2023-01-14 Before firmware normalization
    [rotary_input_board.kicad_sch]
2023-01-14 Toolchain is working but binary is still not working
    [kicad_circular_tracks_test-B_Cu.gbl, kicad_circular_tracks_test-B_Mask.gbs, kicad_circular_tracks_test-B_Paste.gbp, kicad_circular_tracks_test-B_Silkscreen.gbo, kicad_circular_tracks_test-Edge_Cuts.gm1, kicad_circular_tracks_test-F_Cu.gtl, kicad_circular_tracks_test-F_Mask.gts, kicad_circular_tracks_test-F_Paste.gtp]
2023-01-15 Fix for ghost LEDs
    [controller.c]
